AcharyaSudhindra/AegisCan/gateway/README.md

# Tier 3: BeagleBone Black Gateway
## Status: Planned — implement after ESP32-S3 firmware

- SocketCAN + can-utils integration
- PRU-ICSS transmitter fingerprinting
- Web dashboard (Flask/Node)
- ISO 14229 UDS diagnostic gateway
