AcharyaSudhindra/AegisCan/tools/README.md

# Tools & Utilities
## Helper scripts for build, flash, and testing

- CAN frame generator scripts
- BRAM whitelist configuration tools
- Log parser utilities
