AcharyaSudhindra/AegisCan/(commit log)

2026-09-25 esp32 s3 firmware
    [partitions.csv]
2026-09-25 attacker ui and pin connections
